mat327/Projekt_zespolowy/(list of files, drawings)

Other design files:
Untitled Sketch 2.fzz
